Joao03Guilherme/IAD-SBRobot/stl/LegMotor3.stl

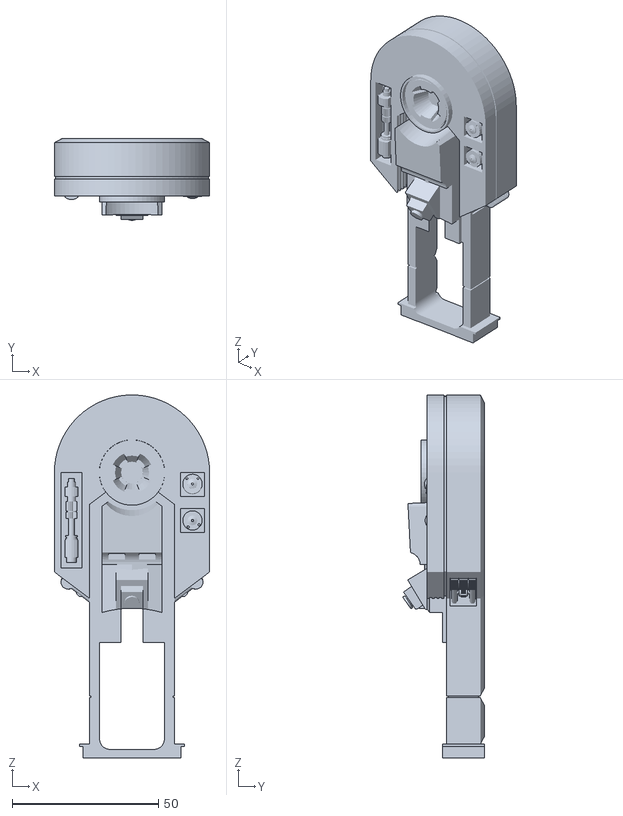
[picture p6: CAD file, 2025-04-30]
stl/LegMotor3.stl
53.0 x 27.9 x 123.9
