Joao03Guilherme/IAD-SBRobot/stl/cabeca.stl

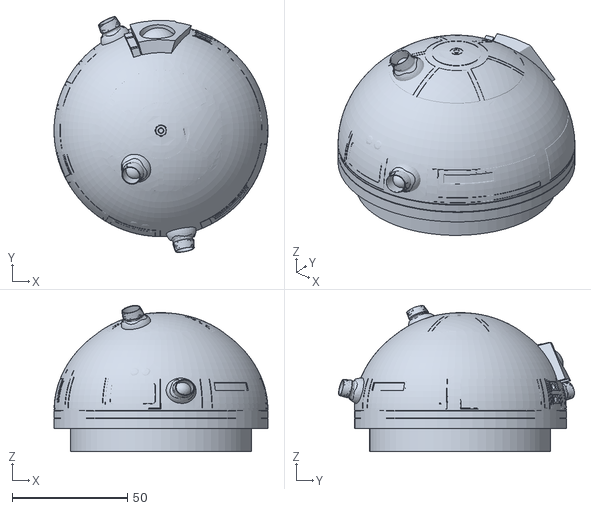
[picture p7: CAD file, 2025-04-16]
stl/cabeca.stl
93.0 x 102.5 x 63.5
