Joao03Guilherme/IAD-SBRobot/stl/BodyHoles.stl

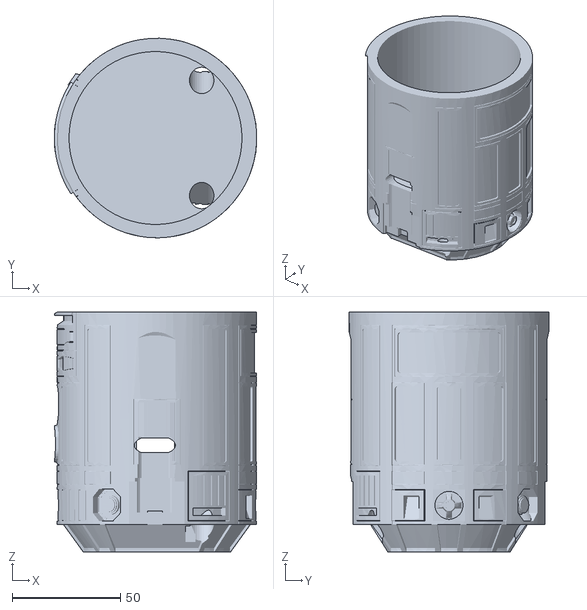
[picture p8: CAD file, 2025-04-16]
stl/BodyHoles.stl
93.6 x 92.3 x 111.0
