Joao03Guilherme/IAD-SBRobot/src/raspberry/controllers/gyroscope_controller.py

from machine import I2C, Pin
import time
import math
import ustruct
import uasyncio as asyncio
from parameters.parameters import data, change_gyro_bias, change_accel_bias


class MPU6050:
    # MPU6050 I2C Address
    MPU_ADDR = data["MPU_CONFIG"]["address"]

    # Register addresses
    ACCEL_XOUT_H = data["MPU_CONFIG"]["accel_xout_h"]
    ACCEL_XOUT_L = data["MPU_CONFIG"]["accel_xout_l"]
    ACCEL_YOUT_H = data["MPU_CONFIG"]["accel_yout_h"]
    ACCEL_YOUT_L = data["MPU_CONFIG"]["accel_yout_l"]
    ACCEL_ZOUT_H = data["MPU_CONFIG"]["accel_zout_h"]
    ACCEL_ZOUT_L = data["MPU_CONFIG"]["accel_zout_l"]

    GYRO_XOUT_H = data["MPU_CONFIG"]["gyro_xout_h"]
    GYRO_XOUT_L = data["MPU_CONFIG"]["gyro_xout_l"]
    GYRO_YOUT_H = data["MPU_CONFIG"]["gyro_yout_h"]
    GYRO_YOUT_L = data["MPU_CONFIG"]["gyro_yout_l"]
    GYRO_ZOUT_H = data["MPU_CONFIG"]["gyro_zout_h"]
    GYRO_ZOUT_L = data["MPU_CONFIG"]["gyro_zout_l"]

    # Accelerometer bias
    BIAS_AX = data["MPU_CONFIG"]["bias_ax"]
    BIAS_AY = data["MPU_CONFIG"]["bias_ay"]
    BIAS_AZ = data["MPU_CONFIG"]["bias_az"]

    # Gyroscope bias
    BIAS_GX = data["MPU_CONFIG"]["bias_gx"]
    BIAS_GY = data["MPU_CONFIG"]["bias_gy"]
    BIAS_GZ = data["MPU_CONFIG"]["bias_gz"]

    # Default is ±250 deg/s range, which gives 131 LSB/(deg/s)
    GYRO_SCALE_FACTOR = data["MPU_CONFIG"]["gyro_scale_factor"]

    # Time constant for complementary filter (in seconds)
    alpha = data["MPU_CONFIG"]["alpha"]

    sample_time = data["PID_CONFIG"]["sample_time"]  # Sample time in seconds

    def __init__(self, sda_pin: int = 26, scl_pin: int = 27) -> None:
        """
        Initialize the MPU6050 sensor interface.

        Args:
            sda_pin (int, optional): SDA pin number. Defaults to 26.
            scl_pin (int, optional): SCL pin number. Defaults to 27.
        Returns:
            None
        """
        self.i2c = I2C(1, sda=Pin(sda_pin), scl=Pin(scl_pin))

        # Additional fixed offset to account for any sensor-to-robot misalignment.
        self.angle_offset = 0
        self._current_pitch = 0

        # Wake up the MPU6050 (exit sleep mode)
        self.i2c.writeto_mem(self.MPU_ADDR, 0x6B, b"\x00")
        time.sleep(0.1)

    def read_raw_data(self, reg_addr: int) -> int:
        """
        Read two bytes from the specified register and convert them into a signed 16-bit integer.

        Args:
            reg_addr (int): Register address to read from.
        Returns:
            int: The signed 16-bit integer value read from the register.
        """
        data = self.i2c.readfrom_mem(self.MPU_ADDR, reg_addr, 2)
        value = ustruct.unpack(">h", data)[0]
        return value

    def read_accel(self) -> tuple[float, float, float]:
        """
        Read the raw accelerometer data and correct the readings.

        Returns:
            tuple[float, float, float]: Corrected accelerometer readings (ax, ay, az) in g's.
        """
        ax = self.read_raw_data(0x3B)
        ay = self.read_raw_data(0x3D)
        az = self.read_raw_data(0x3F)
    # Correct the reading by subtracting the bias then converting to g's (16384 LSB/g for ±2g range).
        ax = (ax - self.BIAS_AX) / 16384.0
        ay = (ay - self.BIAS_AY) / 16384.0
        az = (az - self.BIAS_AZ) / 16384.0
        return ax, ay, az

    def read_gyro(self) -> tuple[float, float, float]:
        """
        Read the raw gyroscope data and correct the readings.

        Returns:
            tuple[float, float, float]: Corrected gyroscope readings (gx, gy, gz) in degrees per second.
        """
        gx = self.read_raw_data(0x43)
        gy = self.read_raw_data(0x45)
        gz = self.read_raw_data(0x47)
        gx = (gx - self.BIAS_GX) / 131.0
        gy = (gy - self.BIAS_GY) / 131.0
        gz = (gz - self.BIAS_GZ) / 131.0
        return gx, gy, gz

    def calibrate_mpu(self, num_samples: int = 1000, delay: float = 0.005) -> None:
        """
        Calibrate sensor biases.

        IMPORTANT:
         - Place the robot in a known, level position and keep it still during calibration.

        The calculated biases are used to ensure that, after correction, the Z axis shows about
        1g (and X & Y near 0) when the robot is level.

        Args:
            num_samples (int, optional): Number of samples to use for calibration. Defaults to 1000.
            delay (float, optional): Delay between samples in seconds. Defaults to 0.005.
        Returns:
            None
        """
        print("Calibrating sensor biases.")
        print("Place the robot in a known, level position and keep it still.")
        ax_sum, ay_sum, az_sum = 0, 0, 0
        gx_sum, gy_sum, gz_sum = 0, 0, 0

        for _ in range(num_samples):
            ax_sum += self.read_raw_data(0x3B)
            ay_sum += self.read_raw_data(0x3D)
            az_sum += self.read_raw_data(0x3F)
            gx_sum += self.read_raw_data(0x43)
            gy_sum += self.read_raw_data(0x45)
            gz_sum += self.read_raw_data(0x47)
            time.sleep(delay)

        avg_ax = ax_sum / num_samples
        avg_ay = ay_sum / num_samples
        avg_az = az_sum / num_samples

        self.BIAS_AX = avg_ax
        self.BIAS_AY = avg_ay
        self.BIAS_AZ = avg_az - 16384
        change_accel_bias(self.BIAS_AX, self.BIAS_AY, self.BIAS_AZ)

        self.BIAS_GX = gx_sum / num_samples
        self.BIAS_GY = gy_sum / num_samples
        self.BIAS_GZ = gz_sum / num_samples
        change_gyro_bias(self.BIAS_GX, self.BIAS_GY, self.BIAS_GZ)
        print(
            "Accelerometer biases (raw units):",
            self.BIAS_AX,
            self.BIAS_AY,
            self.BIAS_AZ,
        )
        print("Gyroscope biases (raw units):", self.BIAS_GX, self.BIAS_GY, self.BIAS_GZ)

        self.calibrate_inclination_offset()
        print("Calibration complete.")
        self.start_update_task()

    def calibrate_inclination_offset(self) -> None:
        """
        Calibrate a fixed inclination offset.
        With the accelerometer calibrated, when the robot is level the computed pitch (inclination)
        should be 0°. Any systematic difference is stored and subtracted from future measurements.

        Returns:
            None
        """
        print("Calibrating inclination offset. Ensure the robot is level.")
        time.sleep(2)
        ax, ay, az = self.read_accel()
        acc_angle = math.degrees(math.atan2(ax, math.sqrt(ay * ay + az * az)))
        self.angle_offset = acc_angle
        print("Angle offset determined at: {:.2f}°".format(self.angle_offset))

    def complementary_filter(self, dt: float, prev_angle: float) -> float:
        """
        Apply a complementary filter to combine:
        - Gyro integrated angle (smooth but drifting).
        - Accelerometer angle (noisy but stable with proper calibration).

        Args:
            dt (float): Time difference between measurements in seconds.
            prev_angle (float): Previous angle estimate.
        Returns:
            float: The filtered angle estimate.
        """
        ax, ay, az = self.read_accel()
        gx, gy, gz = self.read_gyro()

        acc_angle = math.degrees(math.atan2(ay, math.sqrt(ax * ax + az * az)))
        acc_angle -= self.angle_offset

        gyro_angle = prev_angle + gx * dt

        alpha = 0.95
        filtered_angle = alpha * gyro_angle + (1 - alpha) * acc_angle

        return filtered_angle

    _current_pitch = 0

    def start_update_task(self, update_interval: float = 0) -> None:
        """
        Start the background task that updates the pitch angle.

        Args:
            update_interval (float, optional): Interval between updates in seconds. Defaults to sample_time.
        Returns:
            None
        """
        if update_interval <= 0:
            update_interval = self.sample_time
        if not hasattr(self, "_update_task") or self._update_task.done():
            self._update_task = asyncio.create_task(self.update_pitch(update_interval))

    async def update_pitch(self, update_interval: float = 0) -> None:
        """
        Asynchronous task that continuously updates the pitch angle.

        This function should run in a background task.

        Args:
            update_interval (float, optional): Interval between updates in seconds. Defaults to sample_time.
        Returns:
            None
        """
        if update_interval <= 0:
            update_interval = self.sample_time

        last_time = time.ticks_ms()
        while True:
            current_time = time.ticks_ms()
            dt = time.ticks_diff(current_time, last_time) / 1000.0
            last_time = current_time

            self._current_pitch = self.complementary_filter(dt, self._current_pitch)
            await asyncio.sleep(update_interval)

    def get_current_angle(self) -> float:
        """
        Returns the most recent pitch (inclination) angle in degrees.

        This function can be called from other asynchronous tasks.

        Returns:
            float: The most recent pitch angle in degrees.
        """
        return self._current_pitch


if __name__ == "__main__":

    async def main() -> None:
        """
        Main function to initialize the MPU6050, calibrate it, and start the pitch update task.

        Returns:
            None
        """
        mpu = MPU6050(
            sda_pin=data["MPU_CONFIG"]["sda_pin"], scl_pin=data["MPU_CONFIG"]["scl_pin"]
        )

        mpu.calibrate_mpu(num_samples=500)

        asyncio.create_task(mpu.update_pitch())

        while True:
            angle = mpu.get_current_angle()
            print("Current Pitch (inclination): {:.2f}°".format(angle))
            await asyncio.sleep(0.5)

    asyncio.run(main())
