Joao03Guilherme/IAD-SBRobot/src/raspberry/full_bluetooth_pc.py

import asyncio
from bluetooth_controllers.BLEEmitter import BLEEmitter
import parameters.parameters as params
import threading
import queue
import time

"""
THIS CODE SHOULD BE RAN IN THE PC
"""

COMMANDS = params.data["COMMANDS"]
input_queue: queue.Queue[str] = queue.Queue()

def get_user_input() -> None:
    """
    Function to run in a separate thread to get user input from the terminal and put it in a queue.
    
    Args:
        None
    Returns:
        None
    """
    while True:
        print("=" * 100)
        user_input: str = input("\nEnter command: ")
        input_queue.put(user_input)
        # Wait a bit before checking for new input
        time.sleep(0.1)

        if user_input.lower() == "q":
            break

async def interactive_mode(controller: BLEEmitter) -> None:
    """
    Interactive mode to send commands to PicoRobot. Starts a thread for user input and processes commands from the queue.
    
    Args:
        controller (BLEEmitter): The BLEEmitter instance for communication.
    Returns:
        None
    """
    # Start a separate thread for user input
    input_thread = threading.Thread(target=get_user_input, daemon=True)
    input_thread.start()

    # Print the initial menu
    print("\n=== PicoRobot Control Panel ===")
    print("Available Commands:")
    for cmd_num, cmd_info in COMMANDS.items():
        print(f"{cmd_num}: {cmd_info['action']} - {cmd_info['description']}")
    print("q - Quit this program")

    # Process commands from the queue
    running = True
    while running:
        # Check if we have input without blocking
        try:
            # Non-blocking get with a short timeout
            choice: str = input_queue.get(block=False)
            size: int = len(choice.split(" "))

            if size == 3:
                choice, arg1, arg2 = choice.split(" ")

            if choice.lower() == "q":
                break

            if choice.lower() not in COMMANDS:
                print("Invalid command. Please try again.")
                continue

            # Send the command as-is (the robot will parse it)
            if size == 3:
                command: str = f"{choice} {arg1} {arg2}"
            else:
                command: str = choice

            await controller.send_command(command)

        except queue.Empty:
            # No input available, just continue the loop
            pass

        # Allow other asyncio tasks to run (like processing BLE notifications)
        await asyncio.sleep(0.1)

async def main() -> None:
    """
    Main function to create the BLEEmitter, connect to the robot, and run interactive mode.
    Ensures proper disconnection on exit.
    
    Args:
        None
    Returns:
        None
    """
    # Create controller object with telemetry printing disabled
    controller: BLEEmitter = BLEEmitter(verbose_telemetry=False)

    try:
        # Try to connect
        if await controller.connect():
            # Run interactive mode
            await interactive_mode(controller)

    finally:
        # Always disconnect properly
        await controller.disconnect()

# Run the main function
if __name__ == "__main__":
    asyncio.run(main())
