Joao03Guilherme/IAD-SBRobot/src/raspberry/bluetooth_controllers/BLEEmitter.py

from bleak import BleakClient
from bleak import BleakScanner
import parameters.parameters as params
import matplotlib

# Set the backend before importing pyplot
matplotlib.use("TkAgg")  # Use TkAgg backend for better threading support
import matplotlib.pyplot as plt
from matplotlib.animation import FuncAnimation
from collections import deque
import threading
import time
from typing import Deque


class BLEEmitter:
    def __init__(
        self,
        device_address: str = None,
        device_name: str = params.data["PICO_NAME"],
        verbose_telemetry: bool = True,
    ) -> None:
        """
        Initialize the BLEEmitter for communicating with the PicoRobot.

        Args:
            device_address (str, optional): Bluetooth address of the device. Defaults to None.
            device_name (str, optional): Name of the device to connect to. Defaults to value from config.
            verbose_telemetry (bool, optional): Whether to print detailed telemetry. Defaults to True.
        """
        self.device_address = device_address
        self.device_name = device_name
        self.client = None
        self.verbose_telemetry = verbose_telemetry
        self.angle_buffer: Deque[float] = deque(maxlen=100)
        self.balance_angle_buffer: Deque[float] = deque(maxlen=100)
        self.distance_buffer: Deque[float] = deque(maxlen=100)
        self.p_term_buffer: Deque[float] = deque(maxlen=100)
        self.d_term_buffer: Deque[float] = deque(maxlen=100)
        self.i_term_buffer: Deque[float] = deque(maxlen=100)
        self.plot_initialized = False

    async def connect(self) -> bool:
        """
        Connect to the PicoRobot via BLE. If no address is specified, scans for the device by name.

        Returns:
            bool: True if connection is successful, False otherwise.
        """
        # If no address specified, try to find by name
        if not self.device_address:
            print(f"Scanning for {self.device_name}...")
            devices = await BleakScanner.discover()
            for d in devices:
                print(f"{d.address}: {d.name}")
                if d.name == self.device_name:
                    self.device_address = d.address
                    print(f"Found {self.device_name} at {d.address}")
                    break

            if not self.device_address:
                print(f"{self.device_name} not found!")
                return False

        try:
            # Connect to the device
            print(f"Connecting to {self.device_name} at {self.device_address}...")
            self.client = BleakClient(self.device_address)
            await self.client.connect()

            if self.client.is_connected:
                print(f"Connected to {self.device_name}!")

                # Subscribe to telemetry notifications
                await self.client.start_notify(
                    params.data["TELEMETRY_CHAR_UUID"], self._on_telemetry
                )
                print("Subscribed to telemetry notifications")
                self.start_angle_plot()
                return True
            else:
                print("Failed to connect")
                return False

        except Exception as e:
            print(f"Error connecting: {e}")
            return False

    async def disconnect(self) -> None:
        """
        Disconnect from the PicoRobot and stop telemetry notifications and plotting.

        Returns:
            None
        """
        # Stop the plot thread
        if hasattr(self, "plot_running"):
            self.plot_running = False

        if self.client and self.client.is_connected:
            # Unsubscribe from notifications
            try:
                await self.client.stop_notify(params.data["TELEMETRY_CHAR_UUID"])
            except:
                pass
            # Disconnect
            await self.client.disconnect()
            print("Disconnected")

    async def send_command(self, command: str | bytes) -> bool:
        """
        Send a command to the PicoRobot over BLE.

        Args:
            command (str | bytes): The command to send (as string or bytes).
        Returns:
            bool: True if the command was sent successfully, False otherwise.
        """
        if not self.client or not self.client.is_connected:
            print("Not connected!")
            return False

        try:
            # Handle command whether it's a string or bytes
            if isinstance(command, str):
                command_bytes = command.encode()
            else:
                command_bytes = command

            await self.client.write_gatt_char(
                params.data["CONTROL_CHAR_UUID"], command_bytes
            )
            return True
        except Exception as e:
            print(f"Error sending command: {e}")
            return False

    def _on_telemetry(self, sender: int, data: bytes) -> None:
        """
        Handle incoming telemetry data from the PicoRobot.

        Args:
            sender (int): The sender handle.
            data (bytes): The telemetry data received.
        Returns:
            None
        """
        try:
            # Decode the data as a formatted string
            decoded = data.decode()
            if self.verbose_telemetry:
                print(f"Telemetry: {decoded}")

            if ",C" in decoded:
                print(f"\nCurrent config file: {decoded[2:]}")
                return

            # Parse the formatted string into a dictionary
            if "," in decoded:
                telemetry_dict = {}
                parts = decoded.split(",")
                for part in parts:
                    if ":" in part:
                        key, value = part.split(":", 1)
                        telemetry_dict[key] = value

                # Print in a more readable format
                if self.verbose_telemetry:
                    print("Parsed telemetry data:")

                if "M" in telemetry_dict:
                    # Messages
                    message = telemetry_dict["M"]
                    print(f"\nMessage: {message}")

                if "A" in telemetry_dict:
                    angle = float(telemetry_dict["A"])
                    if self.verbose_telemetry:
                        print(f"  Angle: {angle}°")
                    self.angle_buffer.append(angle)

                if "B" in telemetry_dict:
                    balance_angle = float(telemetry_dict["B"])
                    if self.verbose_telemetry:
                        print(f"  Balance target: {balance_angle}°")
                    self.balance_angle_buffer.append(balance_angle * 10)

                if "D" in telemetry_dict:
                    distance = float(telemetry_dict["D"])              
                    if self.verbose_telemetry:
                        print(f"  Distance: {distance}")
                    self.distance_buffer.append(distance)
                    
                if "P" in telemetry_dict:
                    p_term = float(telemetry_dict["P"])              
                    if self.verbose_telemetry:
                        print(f"  p_term: {p_term}")
                    self.p_term_buffer.append(p_term/2)

                if "Y" in telemetry_dict:
                    d_term = float(telemetry_dict["Y"])              
                    if self.verbose_telemetry:
                        print(f"  d_term: {d_term}")
                    self.d_term_buffer.append(d_term/2)

                if "I" in telemetry_dict:
                    i_term = float(telemetry_dict["I"])              
                    if self.verbose_telemetry:
                        print(f"  i_term: {i_term}")
                    self.i_term_buffer.append(i_term/2)

                if self.verbose_telemetry:
                    if "S" in telemetry_dict:
                        print(f"  Speed: {telemetry_dict['S']}")
                    if "T" in telemetry_dict:
                        print(f"  Turn: {telemetry_dict['T']}")
                    if "R" in telemetry_dict:
                        print(
                            f"  Running: {'Yes' if telemetry_dict['R']=='1' else 'No'}"
                        )
                    if "L" in telemetry_dict:
                        print(f"  Left motor: {telemetry_dict['L']}")
                    if "R" in telemetry_dict:
                        print(f"  Right motor: {telemetry_dict['R']}")
        except:
            # If can't decode, show raw data
            if self.verbose_telemetry:
                print(f"📊 Raw telemetry: {data}")

    def start_angle_plot(self) -> None:
        """
        Start a rolling plot for the angle value in a separate thread.

        Returns:
            None
        """
        if self.plot_initialized:
            return

        self.plot_initialized = True
        self.plot_running = True

        # Start plotting in a separate thread
        plot_thread = threading.Thread(target=self._run_plot_thread)
        plot_thread.daemon = True  # Thread will exit when main program exits
        plot_thread.start()

    def _run_plot_thread(self) -> None:
        """
        Run the matplotlib plot in a separate thread, with two separate plots:
        1. Angle and distance plot
        2. PID terms plot
        
        Returns:
            None
        """
        plt.ion()  # Enable interactive mode
        
        # Create two separate figure windows
        self.fig1, self.ax1 = plt.subplots(figsize=(8, 5))
        self.ax1_twin = self.ax1.twinx()  # For distance data
        
        self.fig2, self.ax2 = plt.subplots(figsize=(8, 5))
        
        # First figure - Angle and Distance
        (self.line,) = self.ax1.plot([], [], lw=2, color="blue", label="Current Angle")
        (self.balance_line,) = self.ax1.plot(
            [], [], lw=2, color="red", label="Target Angle (x10)"
        )
        (self.distance_line,) = self.ax1_twin.plot(
            [], [], lw=2, color="green", label="Distance"
        )
        
        # Second figure - PID terms
        (self.p_term_line,) = self.ax2.plot([], [], lw=2, color="purple", label="P Term")
        (self.d_term_line,) = self.ax2.plot([], [], lw=2, color="orange", label="D Term")
        (self.i_term_line,) = self.ax2.plot([], [], lw=2, color="brown", label="I Term")
        (self.pid_sum_line,) = self.ax2.plot([], [], lw=2, color="cyan", label="PID Sum", linestyle='--')
        
        # Configure first plot
        self.ax1.set_ylim(-50, 50)
        self.ax1_twin.set_ylim(-200, 200)  # Set appropriate range for distance
        self.ax1.set_xlim(0, 100)
        self.ax1.grid(True)
        self.ax1.set_title("Angle and Distance Data")
        self.ax1.set_xlabel("Time (ticks)")
        self.ax1.set_ylabel("Angle (°)")
        self.ax1_twin.set_ylabel("Distance (cm)")
        
        # Create a combined legend for first plot
        lines1, labels1 = self.ax1.get_legend_handles_labels()
        lines2, labels2 = self.ax1_twin.get_legend_handles_labels()
        self.ax1.legend(lines1 + lines2, labels1 + labels2, loc="upper right")
        
        # Configure second plot
        self.ax2.set_ylim(-50, 50)
        self.ax2.set_xlim(0, 100)
        self.ax2.grid(True)
        self.ax2.set_title("PID Control Terms")
        self.ax2.set_xlabel("Time (ticks)")
        self.ax2.set_ylabel("Value")
        self.ax2.legend(loc="upper right")
        
        self.fig1.tight_layout()
        self.fig2.tight_layout()
        
        plt.show(block=False)
        
        # Update plots in a loop
        while self.plot_running:
            try:
                # Update FIRST PLOT - angle and distance
                if self.angle_buffer:
                    y_data = [x for x in self.angle_buffer]
                    x_data = list(range(len(y_data)))
                    self.line.set_data(x_data, y_data)
                    
                if self.balance_angle_buffer:
                    y_data = [x for x in self.balance_angle_buffer]
                    x_data = list(range(len(y_data)))
                    self.balance_line.set_data(x_data, y_data)
                    
                if self.distance_buffer:
                    y_data = [x for x in self.distance_buffer]
                    x_data = list(range(len(y_data)))
                    self.distance_line.set_data(x_data, y_data)
                    
                # Update SECOND PLOT - PID terms
                if self.p_term_buffer:
                    y_data = [x for x in self.p_term_buffer]
                    x_data = list(range(len(y_data)))
                    self.p_term_line.set_data(x_data, y_data)
                    
                if self.d_term_buffer:
                    y_data = [x for x in self.d_term_buffer]
                    x_data = list(range(len(y_data)))
                    self.d_term_line.set_data(x_data, y_data)
                    
                if self.i_term_buffer:
                    y_data = [x for x in self.i_term_buffer]
                    x_data = list(range(len(y_data)))
                    self.i_term_line.set_data(x_data, y_data)
                    
                # Update PID sum data
                if self.p_term_buffer and self.i_term_buffer and self.d_term_buffer:
                    min_len = min(len(self.p_term_buffer), len(self.i_term_buffer), len(self.d_term_buffer))
                    y_data = [self.p_term_buffer[i] + self.i_term_buffer[i] + self.d_term_buffer[i] 
                              for i in range(min_len)]
                    x_data = list(range(len(y_data)))
                    self.pid_sum_line.set_data(x_data, y_data)
                    
                # Dynamically adjust x-axis for first plot
                max_len1 = max(
                    len(self.angle_buffer), 
                    len(self.balance_angle_buffer),
                    len(self.distance_buffer),
                    100
                )
                if max_len1 > self.ax1.get_xlim()[1]:
                    self.ax1.set_xlim(0, max_len1)
                    
                # Dynamically adjust x-axis for second plot
                max_len2 = max(
                    len(self.p_term_buffer),
                    len(self.d_term_buffer),
                    len(self.i_term_buffer),
                    100
                )
                if max_len2 > self.ax2.get_xlim()[1]:
                    self.ax2.set_xlim(0, max_len2)
                    
                # Redraw both plots
                self.fig1.canvas.draw()
                self.fig1.canvas.flush_events()
                self.fig2.canvas.draw()
                self.fig2.canvas.flush_events()
                
            except Exception as e:
                print(f"Plot error: {e}")
                
            # Sleep for a short duration to control update rate
            time.sleep(0.1)
            
        # Close both plots when done
        plt.close(self.fig1)
        plt.close(self.fig2)
