Joao03Guilherme/IAD-SBRobot/(commit log)

2025-03-21 added readme for raspberry pi
2025-03-31 accelerometer.py fully functioning
2025-04-01 refactored code and fixed bugs
    [BLEEmitter.py, BLEReceiver.py, accelerometer.py, balance_controller.py, bluethooth_pc.py, bluethooth_raspberry.py, full.py, full_bluetooth_pc.py]
2025-04-01 fixed some issues in full_prototype.py
    [full_bluetooth_pc.py]
2025-04-03 added compatibility between bt and driver
2025-04-07 fixed reset and config commands
    [main.py]
2025-04-07 calibration of gyro
2025-04-08 calibrations updated, accel/gyro filter updated
2025-04-08 valverde shiet
2025-04-08 More coherent wheel encoder distance
2025-04-11 target angle correctd and damping added
    [main.py]
2025-04-15 added music during calibration
2025-04-15 buzzer added, constants improved
    [balance_controller.py, buzzer_controller.py, main.py]
2025-04-16 added demo section
    [BodyHoles.stl, cabeca.stl]
2025-04-30 Added leg STL
    [LegMotor3.stl]
