Joao03Guilherme/IAD-SBRobot/(notices)

Notices in the files:
readme.md:
License: MIT
